ibbu98/BOARD-3-GOLDEN-ARDUINO/SCHEMATICS/golden_arduino_schematics.pdf

# GND Gnd Sgn

# +5 Power Supply

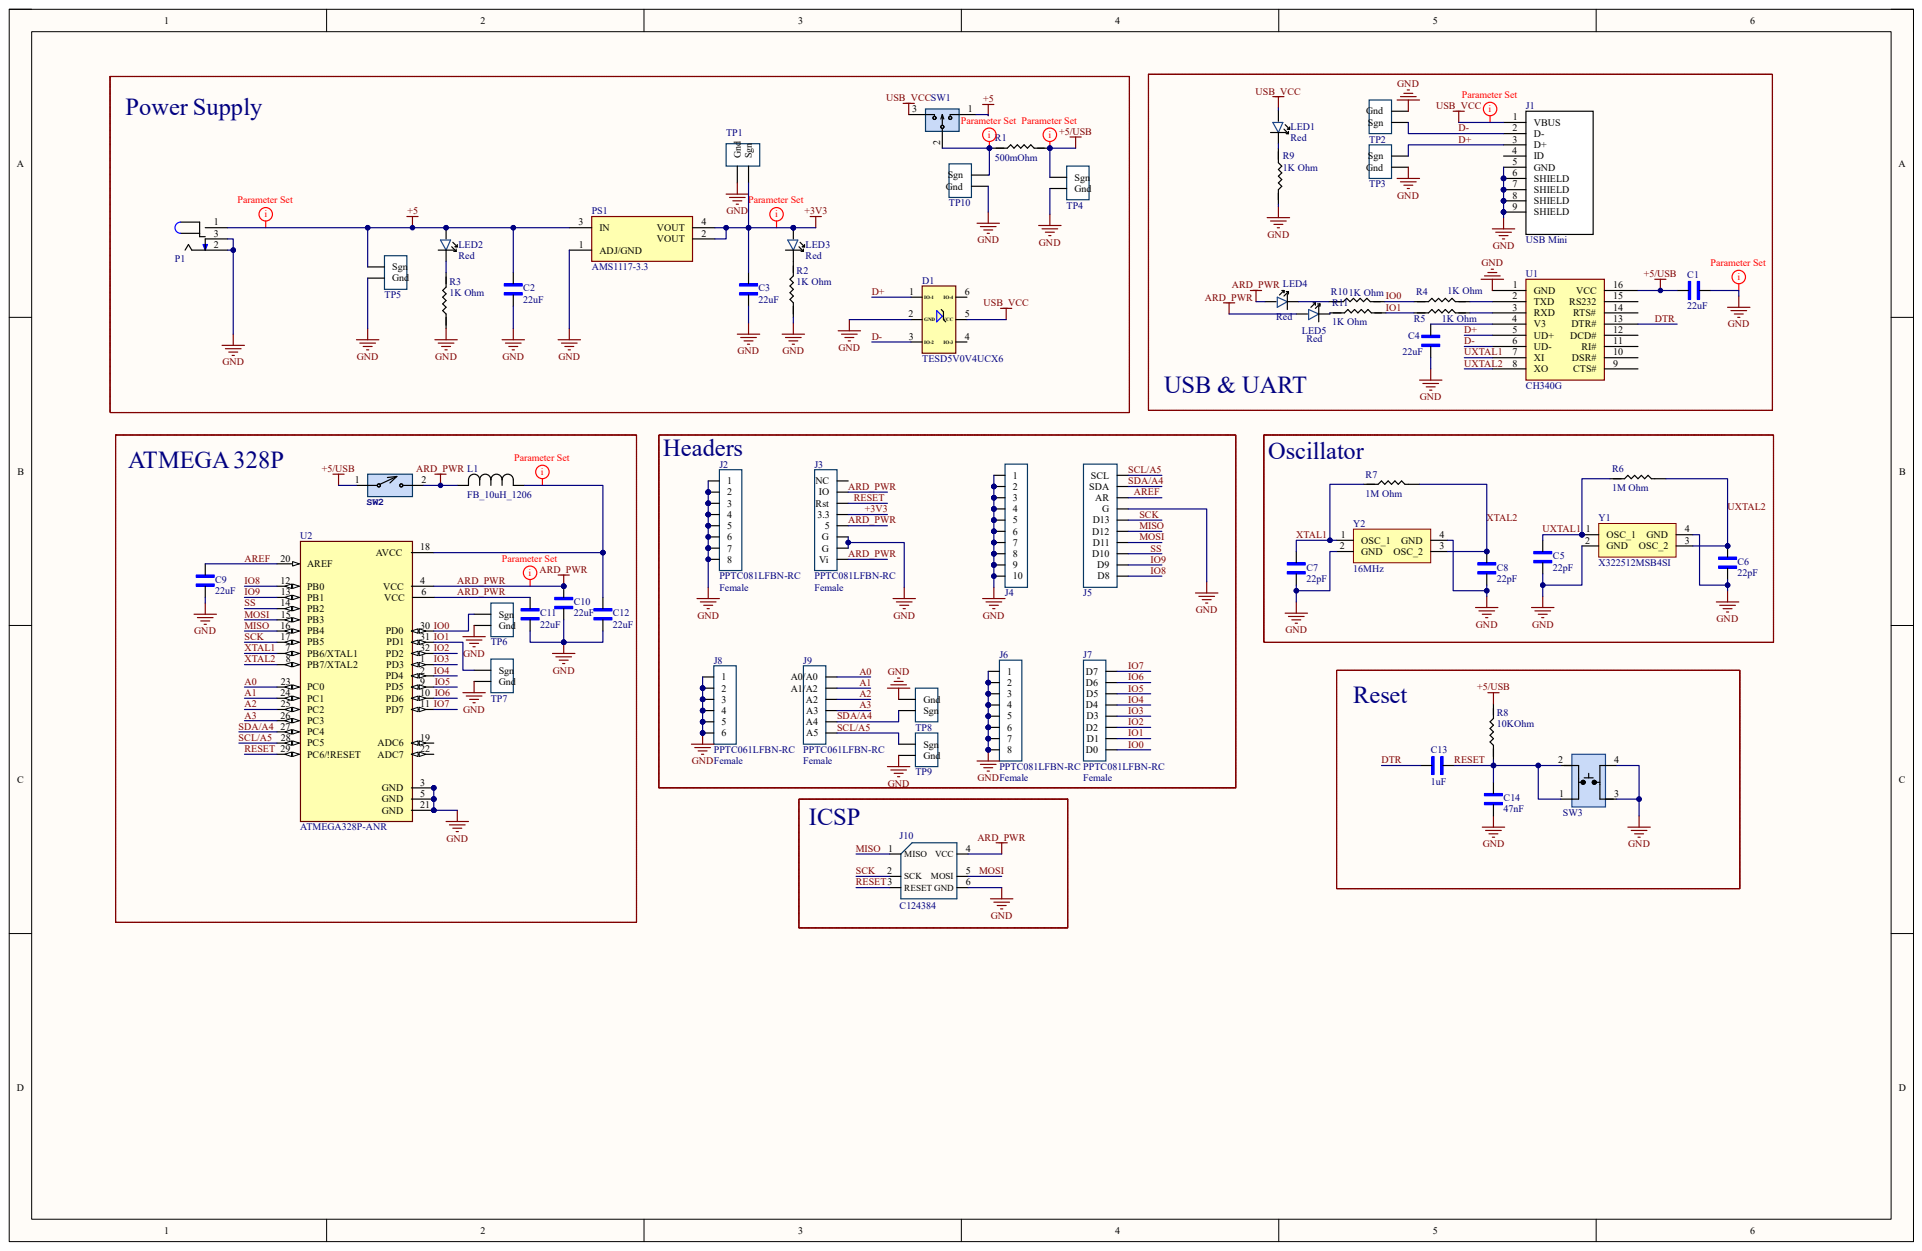
[picture p28: page 1]
