ibbu98/BOARD-3-GOLDEN-ARDUINO/LAYOUT/golden_arduino_layout.pdf

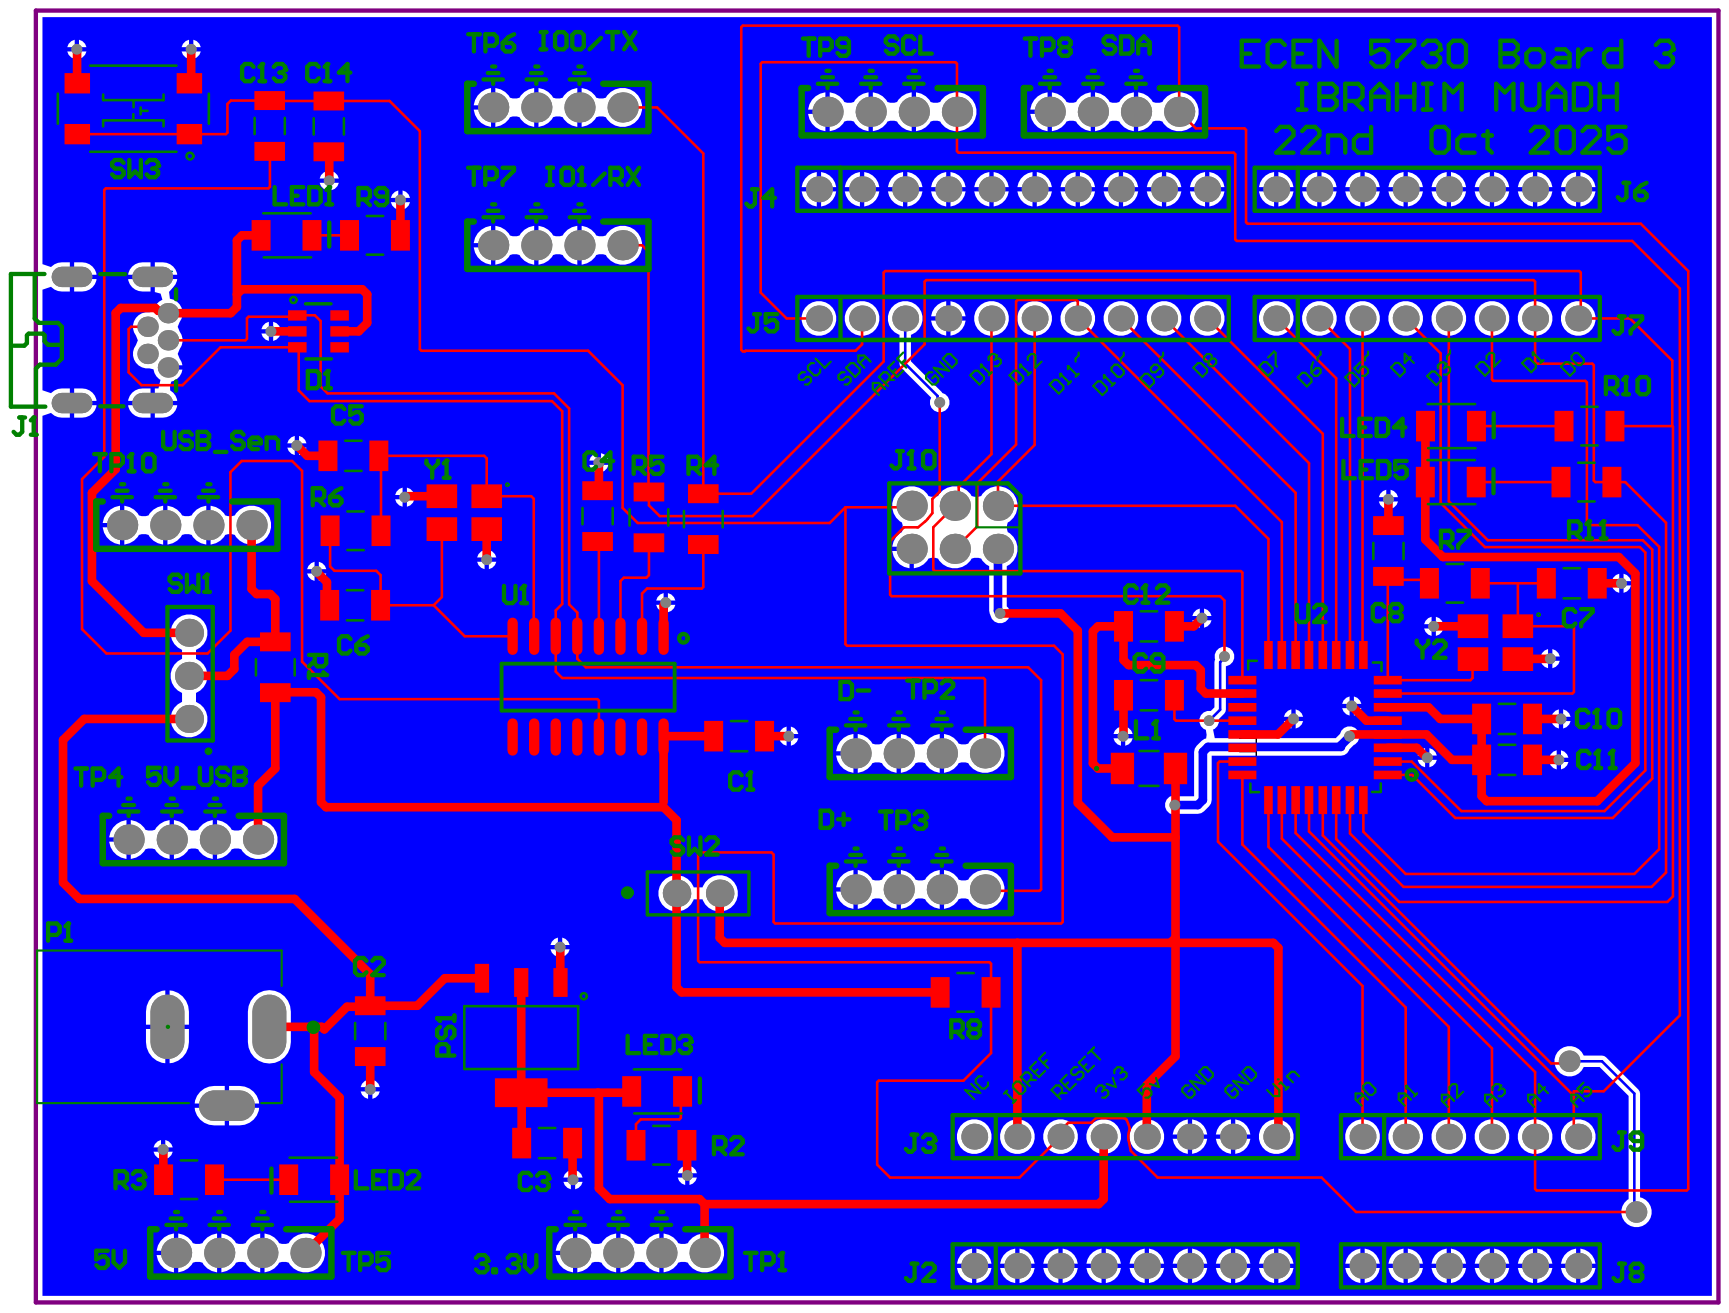
[picture p29: page 1]
