ibbu98/BOARD-3-GOLDEN-ARDUINO/(list of files, drawings)

Other design files:
LAYOUT/golden_arduino.PcbDoc
SCHEMATICS/golden_arduino.SchDoc
