ibbu98/BOARD-3-GOLDEN-ARDUINO/(commit log)

2025-11-16 Add README for BOARD 3 - GOLDEN-ARDUINO-LAYOUT
2025-11-16 Add initial README for BOARD 3 - GOLDEN - ARDUINO
